The8BitEnthusiast/microcontroller-display/Schematics/8BitCPUOutputModule.pdf

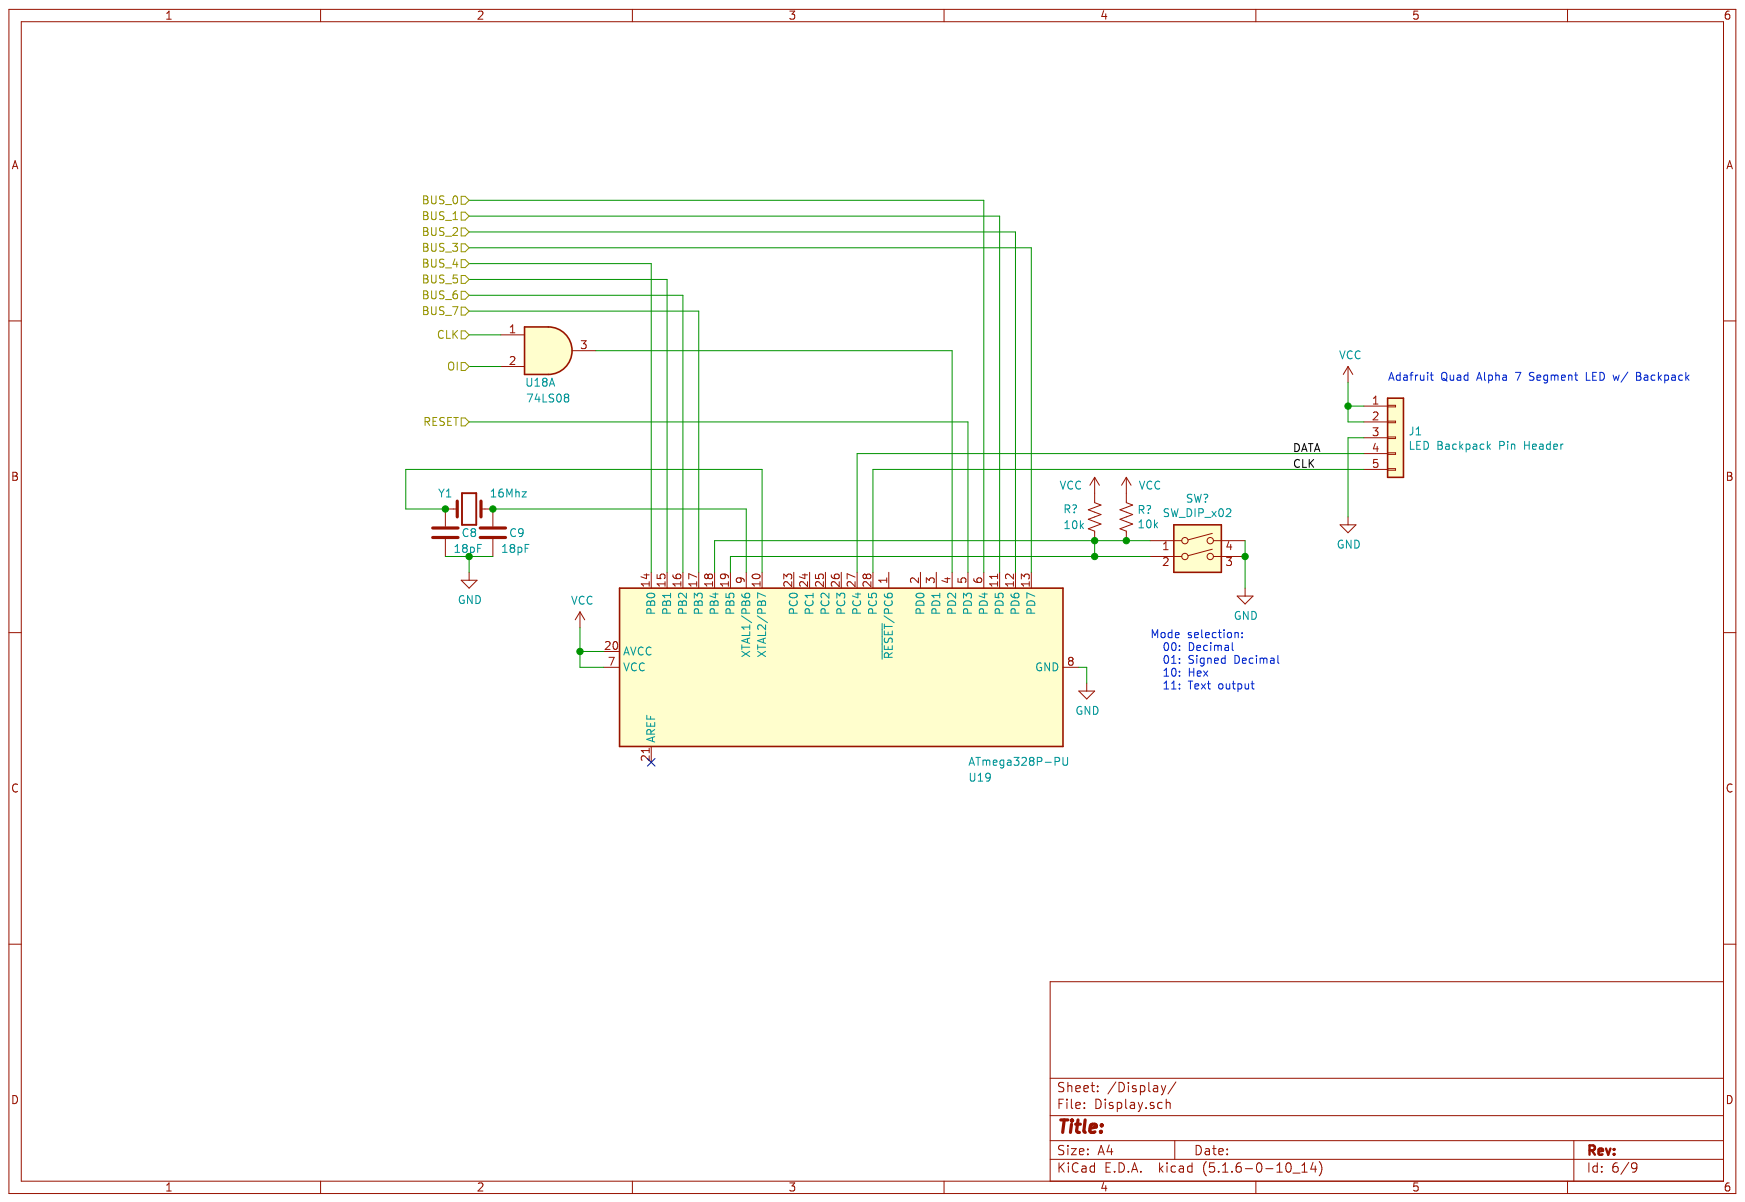
[picture p4: page 1]
